fieldkit/weather/hardware/module-board/fk-weather.kicad_pcb

## KiCad design hardware/module-board/fk-weather.kicad_pcb (2018-12-20)

Schematic: fk-weather.sch, fk-core

Parts:
BT1: BATTERY_CELL; BAT_CR1210
C1, C2: 18pF; CAP-0603
C3, C4, C6, C7, C8, C13, C16, C18, C20: 100nF; CAP-0603
C5, C11, C12: 1uF; CAP-0603
C9, C14: 4.7uF; CAP-0603
C10: 4.7nF; CAP-0603
C15, C21: 10uF; CAP-0603
C17, C19: 10nF; CAP-0603
D1: Green; LED-0603
D4: PRTR5V0U2X; SOT-143B
D5: Orange; LED-0603
D6, D7, D8, D9, D10, D11: DIODE; SOD-123
F1: MF-PSMF050X-2; MF-PSMF020X
J1: MICRO-USB; USB_1051330011
J2, J7: CONN_01x05; Molex_CLIK-Mate_502382-0570_1x05_P1.25mm_Vertical
J3: CONN_01x03_SERIAL; Molex_CLIK-Mate_502382-0370_1x03_P1.25mm_Vertical
J4: CONN_01x04; Molex_CLIK-Mate_502382-0470_1x04_P1.25mm_Vertical
J5: MICRO-USB; USB_10118193-0001LF-core-mod
J6: CONN_02x05_SWD; HDR_02x05_Pitch1.27mm_SMD_SWD
J8: CONN_01x04; BM04B-SRSS-TB
J9, J12: CONN_01x02; SJ_OPEN
J10, J11: CONN_01x06; WURTH_615006138421
L1, L2: BLM18KG221SN1D; IND-0603
M1, M2, M3, M4: MOUNT_HOLE; HOLE_NPTH_2.7MM
Q4: 2N7002LT1G; SOT-23
R1, R22, R23, R30, R31, R32, R33: 1K; RES-0603
R2, R9: 330R; RES-0603
R3, R17: 2k2; RES-0603
R4, R5, R12: 10K; RES-0603
R6, R7, R16, R18, R19, R20, R34: 4.7K; RES-0603
R8, R14, R15: 100K; RES-0603
R10: 1M; RES-0603
R11, R13: ?; RES-0603
SW1: SPNO; SW_SPST_WURTH_1
U1: ATSAMD21G18A-AU; TQFP-48_7x7mm_Pitch0.5mm
U2: MCP1700T-3302E/MB; SOT-89
U3: TPS2052B; SOIC-8-N
U4: S25FL116K0XMFI041; SOIC-8-N-WIDE
U5: SK6812
U6: PCF8523; SOIC-8-N
Y1, Y2: FC-135; ABS07

Connections:
3V3: C3.1, C7.1, C8.1, C12.1, C16.1, C17.1, D1.2 (A), D5.2 (A), J2.1, J4.1, J6.1, J7.1, J8.2, J9.1, J12.1, L2.2, R1.1, R4.1, R5.2, R6.2, R7.2, R8.1, R12.2, R16.2, R18.2, R19.2, R20.2, U1.17 (VDDIO), U1.36 (VDDIO), U1.44 (VDDIN), U2.3 (VOUT), U3.2, U5.3 (VDD), U6.8 (VDD)
5V0: C9.1, C11.1, L1.1, U2.2 (VIN)
/A0: U1.3 (PA02)
/A1_WIND_DIR: D8.1 (K), D9.2 (A), R30.2, R34.2, U1.7 (PB08)
/A3: U1.9 (PA04), U5.2 (DI)
/A4: U1.10 (PA05)
/A5: U1.47 (PB02)
/ATN: U1.22 (PA13)
/D0: U1.16 (PA11)
/D1: U1.15 (PA10)
/D2: U1.23 (PA14)
/D5_FLASH_CS: U1.24 (PA15), U4.1 (~CS~)
/D6_RAIN: D6.2 (A), D7.1 (K), R32.2, U1.29 (PA20)
/D7_WEATHER_EN: R11.1, U1.30 (PA21), U3.3
/D8_PERIPH_EN: R13.1, U1.11 (PA06), U3.4
/D9: U1.12 (PA07)
/D10_WIND_SPEED: D10.2 (A), D11.1 (K), R33.2, U1.27 (PA18)
/D12: U1.28 (PA19)
/D13: Q4.1 (G), U1.26 (PA17)
/D30: J3.3 (D30), U1.37 (PB22)
/D31: J3.2 (D31), U1.38 (PB23)
/MISO: U1.21 (PA12), U4.2 (SO/IO1)
/MOSI: U1.19 (PB10), U4.5 (SI/IO0)
/PERIPH_3V3: C18.1, C20.1, C21.1, J9.2, R14.1, U3.6, U4.3 (~WP~/IO2), U4.7 (~HOLD~/IO3), U4.8 (VCC)
/RAIN_2: J10.2
/RAIN_5: J10.5
/RESET: R2.1, U1.40 (RESETN)
/RST: J6.10, R2.2, R4.2, SW1.2; also elsewhere on the board
/RX_LED: U1.48 (PB03)
/SCK: U1.20 (PB11), U4.6 (SCLK)
/SCL1: J4.3, J8.4, R7.1, R20.1, U1.32 (PA23), U6.6 (SCL)
/SCL2: J2.4, J7.4, R18.1, U1.14 (PA09)
/SDA1: J4.4, J8.3, R6.1, R19.1, U1.31 (PA22), U6.5 (SDA)
/SDA2: J2.5, J7.5, R16.1, U1.13 (PA08)
/SWCLK: J6.4, U1.45 (PA30)
/SWDIO: J6.2, U1.46 (PA31)
/TX_LED: U1.39 (PA27)
/USB+: D4.2, J1.3 (D+), J5.3 (D+), U1.34 (PA25)
/USB-: D4.3, J1.2 (D-), J5.2 (D-), U1.33 (PA24)
/USB_ID: R9.2, U1.41 (PA28)
/WEATHER_3V3: C13.1, C15.1, D6.1 (K), D9.1 (K), D10.1 (K), J12.2, R15.1, R34.1, U3.7
GND: BT1.2 (-), C1.1, C2.1, C3.2, C4.2, C5.2, C6.2, C7.2, C8.2, C9.2, C10.2, C11.2, C12.2, C13.2, C14.2, C15.2, C16.2, C17.2, C18.2, C19.2, C20.2, C21.2, D4.1, D7.2 (A), D8.2 (A), D11.2 (A), J1.5 (GND), J2.2, J3.1 (GND), J4.2, J5.5 (GND), J6.3, J6.5, J6.9, J7.2, J8.1, Q4.2 (S), R3.2, R10.2, R11.2, R13.2, R14.2, R15.2, R22.2, R23.2, R31.2, SW1.1, U1.5 (GNDANA), U1.18 (GND), U1.35 (GND), U1.42 (GND), U2.1 (GND), U3.1, U4.4 (VSS), U5.1 (GND), U6.4 (VSS); also elsewhere on the board
unnamed: BT1.1 (+), U6.3 (VBAT)
unnamed: C1.2, U1.2 (PA01), Y1.1
unnamed: C2.2, U1.1 (PA00), Y1.2
unnamed: C4.1, L2.1, U1.6 (VDDANA)
unnamed: C5.1, U1.43 (VDDCORE)
unnamed: C10.1, J1.6 (SHIELD), J5.7 (SHIELD), R10.1
unnamed: C6.1, C14.1, U1.4 (PA03)
unnamed: C19.1, R1.2
unnamed: D1.1 (K), R3.1
unnamed: D5.1 (K), R17.1
unnamed: F1.1, L1.2
unnamed: J1.4 (ID), J5.4 (ID), R8.2, R9.1
unnamed: J10.3, R23.1
unnamed: J10.4, R32.1
unnamed: J11.2, R22.1
unnamed: J11.3, R31.1
unnamed: J11.4, R33.1
unnamed: J11.5, R30.1
unnamed: Q4.3 (D), R17.2
unnamed: R5.1, U3.8
unnamed: R12.1, U3.5
unnamed: U6.1 (XI), Y2.2
unnamed: U6.2 (XO), Y2.1
VUSB: D4.4, F1.2, J1.1 (VBUS), J5.1 (VBUS)

Notes on the sheet:
TX0
RX0
32.768kHz
12.5pF
USB / POWER MANAGEMENT
LEDs
MCU
I2C
EXTERNAL SENSOR
RAIN
WIND
RTC
MOUNTING
FLASH
CORE CONNECTOR
EXTERNAL SERIAL
PERIPHERALS

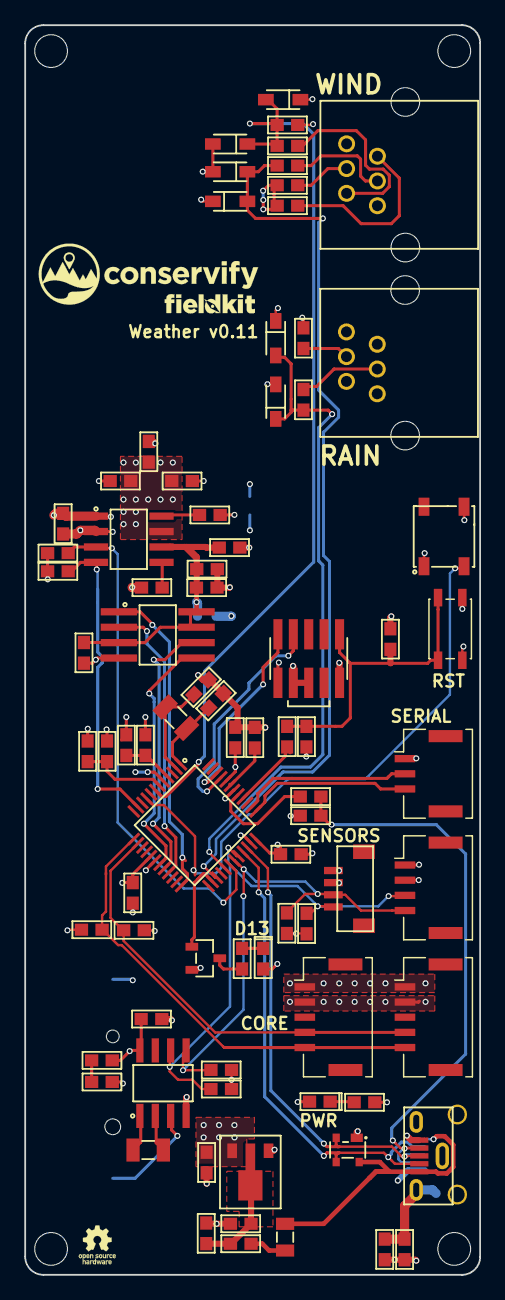
[picture p1: board fk-weather.kicad_pcb from above]

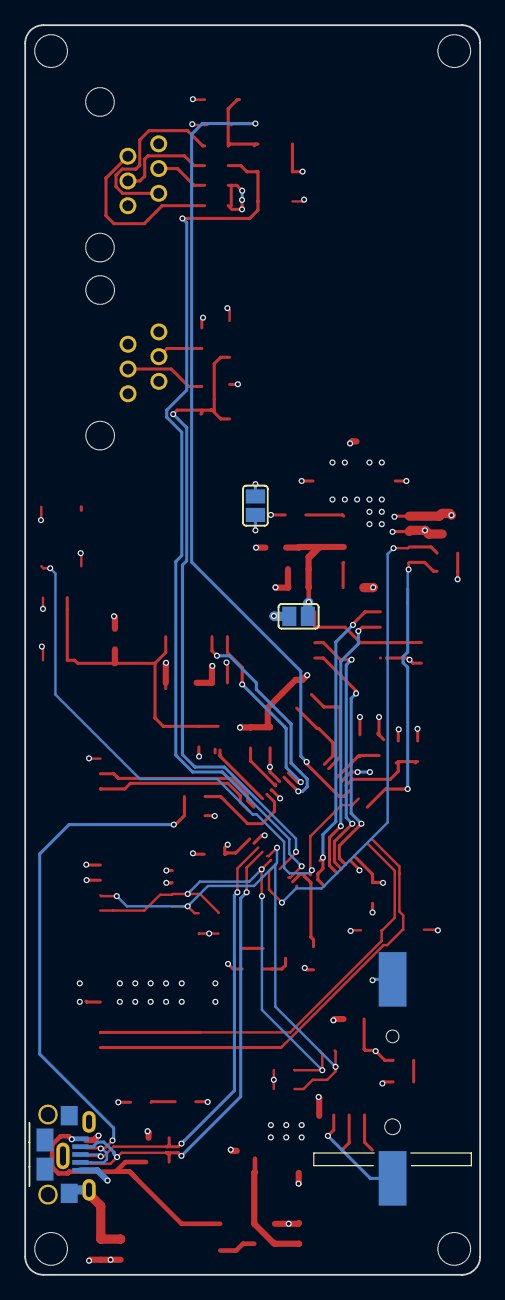
[picture p2: board fk-weather.kicad_pcb from below]

Board: 4 copper layers, 37.5 x 103.0 mm, 88 parts (4 on the bottom side), 53 nets.

Other parts of the board:
C22: 100nF; CAP-0603

Their connections:
/RST: C22.1; also elsewhere on the board
GND: C22.2; also elsewhere on the board
