fieldkit/weather/hardware/sensor-board/fk-weather-sensors.kicad_pcb

## KiCad design hardware/sensor-board/fk-weather-sensors.kicad_pcb (2018-09-24)

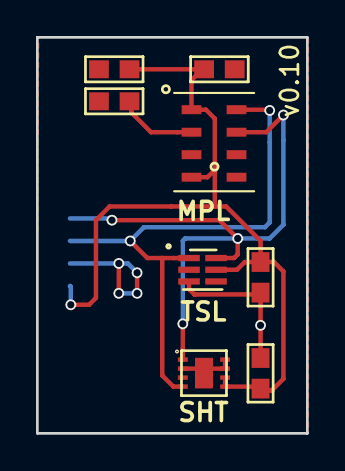
[picture p3: board fk-weather-sensors.kicad_pcb from above]

Board: 2 copper layers, 15.0 x 22.0 mm, 9 parts (1 on the bottom side), 5 nets.

Parts:
C1, C2, C5: 100nF; CAP-0603
C3: 1uF; CAP-0603
C4: 10uF; CAP-0603
J1: CONN_01x04; Molex_CLIK-Mate_502382-0470_1x04_P1.25mm_Vertical
U1: MPL3115A2; DFN-8-1EP_5x2.55mm_Pitch1.25mm_98ASA002260D
U2: TSL2591
U3: SHT31; SHT3x

Connections:
3V3: C2.1, C3.1, C4.1, C5.1, J1.1, U1.1, U1.4, U2.5, U3.5, U3.6
/SCL: J1.3, U1.8, U2.1, U3.4
/SDA: J1.4, U1.7, U2.6, U3.1
GND: C1.2, C2.2, C3.2, C4.2, C5.2, J1.2, U1.3, U2.3, U3.2, U3.7, U3.8, U3.PAD
unnamed: C1.1, U1.2
