fieldkit/weather/firmware/common/ambient_sensors.h

#ifndef FK_AMBIENT_SENSORS_H_INCLUDED
#define FK_AMBIENT_SENSORS_H_INCLUDED

#include "debug.h"
#include "module_hardware.h"

namespace fk {

class AmbientSensors {
private:
    WeatherHardware *hw;

public:
    AmbientSensors(WeatherHardware &hw);

public:
    void takeReading();

};

}

#endif
