fieldkit/weather/firmware/test/check.h

#ifndef FK_CHECK_H_INCLUDED
#define FK_CHECK_H_INCLUDED

#include <module_hardware.h>

namespace fk {

class Check {
private:
    WeatherHardware *hw;

public:
    Check(WeatherHardware &hw);

public:
    bool sht31();
    bool mpl3115a2();
    bool tsl2591();
    bool flashMemory();
    bool check();
    void failed();

};

}

#endif
