fieldkit/weather/(commit log)

2017-03-13 First commit.
    [fk-weather.kicad_pcb, fk-weather.sch]
2017-04-01 Read outside temperature from an attached DHT22
2017-07-25 Starting on the basic sensor module board. Just IC stuff.
    [fk-weather.kicad_pcb, fk-weather.sch]
2017-07-26 Adding pull ups, fixing the outline. Plotting.
    [fk-weather-B.Cu.gbr, fk-weather-B.Mask.gbr, fk-weather-B.Paste.gbr, fk-weather-B.SilkS.gbr, fk-weather-Edge.Cuts.gbr, fk-weather-F.Cu.gbr, fk-weather-F.Mask.gbr, fk-weather-F.Paste.gbr]
2017-07-26 Adding USB connector and 3v3 regulator.
    [fk-weather-B.Cu.gbr, fk-weather-B.Mask.gbr, fk-weather-B.Paste.gbr, fk-weather-B.SilkS.gbr, fk-weather-Edge.Cuts.gbr, fk-weather-F.Cu.gbr, fk-weather-F.Mask.gbr, fk-weather-F.Paste.gbr]
2017-07-26 Adding MAX4466.
    [fk-weather-B.Cu.gbr, fk-weather-B.Mask.gbr, fk-weather-B.Paste.gbr, fk-weather-B.SilkS.gbr, fk-weather-Edge.Cuts.gbr, fk-weather-F.Cu.gbr, fk-weather-F.Mask.gbr, fk-weather-F.Paste.gbr]
2017-07-26 Fix part for ferrite beads, replot.
    [fk-weather-B.Cu.gbr, fk-weather-B.Mask.gbr, fk-weather-B.Paste.gbr, fk-weather-B.SilkS.gbr, fk-weather-Edge.Cuts.gbr, fk-weather-F.Cu.gbr, fk-weather-F.Mask.gbr, fk-weather-F.Paste.gbr]
2017-08-18 Fixing footprints for light and pressure.
    [fk-weather.kicad_pcb, fk-weather.sch]
2017-08-23 Fixing USB oval drills.
    [fk-weather.kicad_pcb, fk-weather.sch]
2017-08-23 Arranging labels for printing out an assembly map.
    [fk-weather.kicad_pcb, fk-weather.sch]
2017-08-24 Working on layout issues, trying to figure out the MCU problem.
    Also broke up power from USB.
    [fk-weather-B.Cu.gbr, fk-weather-B.Mask.gbr, fk-weather-B.Paste.gbr, fk-weather-B.SilkS.gbr, fk-weather-Edge.Cuts.gbr, fk-weather-F.Cu.gbr, fk-weather-F.Mask.gbr, fk-weather-F.Paste.gbr]
2017-09-12 Export new gerbers.
    [fk-weather-B.Cu.gbr, fk-weather-B.Mask.gbr, fk-weather-B.Paste.gbr, fk-weather-B.SilkS.gbr, fk-weather-Edge.Cuts.gbr, fk-weather-F.Cu.gbr, fk-weather-F.Mask.gbr, fk-weather-F.Paste.gbr]
2017-09-14 Programming header was wrong from the SMD switch.
    [fk-weather.kicad_pcb, fk-weather.sch]
2017-09-15 Adding an LED to D13
    [fk-weather.kicad_pcb, fk-weather.sch]
2017-09-15 Removing extraneous headers.
    [fk-weather.kicad_pcb, fk-weather.sch]
2017-09-15 Adding a header for an LED.
    [fk-weather.kicad_pcb, fk-weather.sch]
2017-09-15 Nudge button over.
    [fk-weather.kicad_pcb]
2017-09-27 Wire ADDR on SHT31 to GND.
    [fk-weather.kicad_pcb, fk-weather.sch]
2017-10-02 Some parts.
    [fk-weather.sch]
2017-11-02 Add way to isolate sensors in from the bus in testing.
    [fk-weather.kicad_pcb, fk-weather.sch]
2017-11-02 Separate I2C for BNO055, also break a third out for fk-core.
    [fk-weather.kicad_pcb, fk-weather.sch]
2017-11-03 New gerbers.
    [fk-weather-B.Cu.gbr, fk-weather-B.Mask.gbr, fk-weather-B.Paste.gbr, fk-weather-B.SilkS.gbr, fk-weather-Edge.Cuts.gbr, fk-weather-F.Cu.gbr, fk-weather-F.Mask.gbr, fk-weather-F.Paste.gbr]
2017-11-17 Using a better SHT3x footprint.
    [fk-weather.kicad_pcb, fk-weather.sch]
2017-11-17 Test firmware that runs through all the devices.
2017-11-17 Fixing up some parts to work with our BOM scripts.
    [fk-weather.sch]
2017-11-27 Adding flash memory to the schematic.
    [fk-weather.sch]
2017-11-28 Adding flash memory to PCB. Plotting.
    [fk-weather-B.Cu.gbr, fk-weather-B.Mask.gbr, fk-weather-B.Paste.gbr, fk-weather-B.SilkS.gbr, fk-weather-Edge.Cuts.gbr, fk-weather-F.Cu.gbr, fk-weather-F.Mask.gbr, fk-weather-F.Paste.gbr]
2017-11-29 Rounding corners of the PCB.
    [fk-weather-B.Cu.gbr, fk-weather-B.Mask.gbr, fk-weather-B.Paste.gbr, fk-weather-B.SilkS.gbr, fk-weather-Edge.Cuts.gbr, fk-weather-F.Cu.gbr, fk-weather-F.Mask.gbr, fk-weather-F.Paste.gbr]
2017-12-08 Fix version number.
    [fk-weather-B.Cu.gbr, fk-weather-B.Mask.gbr, fk-weather-B.Paste.gbr, fk-weather-B.SilkS.gbr, fk-weather-Edge.Cuts.gbr, fk-weather-F.Cu.gbr, fk-weather-F.Mask.gbr, fk-weather-F.Paste.gbr]
2017-12-20 Adding another breakout for the MIC to attach a header to for probing.
    [fk-weather.kicad_pcb, fk-weather.sch]
2017-12-20 Make fab labels easier to read.
    [fk-weather.kicad_pcb]
2017-12-21 Reading sensor data. Also some basic analog sampling code.
2017-12-22 Actually fill in module sensor readings.
2017-12-22 Use new module status return for backoff.
    This tells core to give us some time to ourselves so we can use the I2C
    bus to talk to *our* sensors.
2017-12-24 Setup watchdog (to setup the leds)
2017-12-28 Hardware will becoem two boards. Make dir.
    [fk-weather.kicad_pcb, fk-weather.sch]
2017-12-28 Will regenerate these.
    [fk-weather-B.Cu.gbr, fk-weather-B.Mask.gbr, fk-weather-B.Paste.gbr, fk-weather-B.SilkS.gbr, fk-weather-Edge.Cuts.gbr, fk-weather-F.Cu.gbr, fk-weather-F.Mask.gbr, fk-weather-F.Paste.gbr]
2017-12-28 Adding PCB/sch for the wind/rain connectors.
    [fk-weather.kicad_pcb, fk-weather.sch]
2017-12-28 First pass on the sensor board.
    [fk-weather-sensors.kicad_pcb, fk-weather-sensors.sch]
2017-12-28 Removing sensors from module board.
    [fk-weather.kicad_pcb, fk-weather.sch]
2017-12-28 Wire up the I2C buses to the header.
    [fk-weather.kicad_pcb, fk-weather.sch]
2017-12-28 Fix RJ11 jacks. Clean up the board and I2C lines.
    Got rid of the solder jumpers and just broke both out.
    [fk-weather.kicad_pcb, fk-weather.sch]
2017-12-28 Expose Serial2 (D31/D30)
    [fk-weather.kicad_pcb, fk-weather.sch]
2017-12-28 Change header orien. Plot.
    [fk-weather-B.Cu.gbr, fk-weather-B.Mask.gbr, fk-weather-B.Paste.gbr, fk-weather-B.SilkS.gbr, fk-weather-Edge.Cuts.gbr, fk-weather-F.Cu.gbr, fk-weather-F.Mask.gbr, fk-weather-F.Paste.gbr]
2017-12-29 PCB labels for D30/D31
    [fk-weather.kicad_pcb]
2018-01-06 Change version to 0.6.
    [fk-weather-B.Cu.gbr, fk-weather-B.Mask.gbr, fk-weather-B.Paste.gbr, fk-weather-B.SilkS.gbr, fk-weather-Edge.Cuts.gbr, fk-weather-F.Cu.gbr, fk-weather-F.Mask.gbr, fk-weather-F.Paste.gbr]
2018-01-20 Using the prettier footprints for some passives.
    [fk-weather.kicad_pcb, fk-weather.sch]
2018-01-22 Fix TSL2591 footprint.
    [fk-weather-sensors.kicad_pcb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]
2018-01-23 Bugfix, using the same variable twice.
    [readings.cpp]
2018-01-23 Fix number of sensors.
    [main.cpp]
2018-01-23 Using secondary I2C for core communications.
2018-01-23 Initialize the sensors at startup.
2018-01-24 Save persisted state into SerialFlash.
    This ensures our long term values don't get erased and that they stay
    consistent. Especially due to our stability issues on I2C now.
    [WeatherMeters.cpp, WeatherMeters.h, main.cpp]
2018-01-24 Fix persisted save saving. Also uses a lower level mechanism.
    [WeatherMeters.cpp, WeatherMeters.h]
2018-01-25 FlashStorage alternates between two blocks.
    This is so that we have a value to fall back on if we happen to be
    interrupted during a write.
2018-02-15 Plotting new gerbers. Bump version.
    [fk-weather-sensors-B.Cu.gbr, fk-weather-sensors-B.Mask.gbr, fk-weather-sensors-B.Paste.gbr, fk-weather-sensors-B.SilkS.gbr, fk-weather-sensors-F.Cu.gbr, fk-weather-sensors-F.Mask.gbr, fk-weather-sensors-F.SilkS.gbr, fk-weather-sensors.drl]
2018-03-02 Drop daily values, add previous hour of rain and hourly wind gust.
    The idea of a day is awkward in the context of the station because we don't
    necessarily know the time zone, etc... So it's easier to build daily
    values after the fact from hourly information.
    Also, having previous hour is good because that's probably a more accurate
    value than using some arbitrary sample in the current hour.
2018-03-02 Change startup order to setup Watchdog earlier.
    I noticed something hang, probably during scanning for weather sensors and
    hopefully with the earlier watchdog startup we can restart and get out.
2018-03-05 Using key names for sensors. Going to pretty up using metadata.
2018-03-21 Bump revision. Nudge some parts.
    [fk-weather.kicad_pcb]
2018-03-21 Use Zero RTC for our "meters clock" instead of managing our own.
    The idea here is that this will meant he weather meter data is nearly
    always synced to the proper time. Even in the rare cases where we're
    confused about the time. Hell, once we get a time the time is usually
    correct from then on.
    [WeatherMeters.cpp, WeatherMeters.h, main.cpp, readings.cpp]
2018-03-23 Don't try and read other sensors that we can't find.
2018-04-19 Use taskQueue for sensor task.
2018-05-01 Migrate to arduino-logging.
2018-05-07 Add NFET for peripherals. In this case just the flash.
    [fk-weather.kicad_pcb, fk-weather.sch]
2018-05-21 Updating BOM details.
    [fk-weather.sch]
2018-07-03 Add dimensions.
    [fk-weather.kicad_pcb]
2018-07-03 Add connectors. Clean up mounting hole locations.
    [fk-weather.kicad_pcb, fk-weather.sch]
2018-07-06 Adding high side switch for peripherals.
    [fk-weather.kicad_pcb, fk-weather.sch]
2018-07-10 Plotting gerbers.
    [fk-weather-B.Cu.gbr, fk-weather-B.Mask.gbr, fk-weather-B.Paste.gbr, fk-weather-B.SilkS.gbr, fk-weather-Edge.Cuts.gbr, fk-weather-F.Cu.gbr, fk-weather-F.Mask.gbr, fk-weather-F.Paste.gbr]
2018-07-18 Easier to read labels.
    [fk-weather-sensors.kicad_pcb, fk-weather.kicad_pcb]
2018-07-18 Enable peripherals on startup. Also kill them on fatal errors.
    [ModuleHardware.cpp, WeatherMeters.cpp, readings.cpp]
2018-07-23 Drop large header. Add debug. Drop LEDs.
    [fk-weather.kicad_pcb, fk-weather.sch]
2018-07-23 Same size as Core board.
    [fk-weather.kicad_pcb]
2018-07-23 Add RTC. Molex connector cleanup. Add RGB LED.Fix diode footprints.
    [fk-weather-sensors.kicad_pcb, fk-weather-sensors.sch, fk-weather.kicad_pcb, fk-weather.sch]
2018-07-23 Add a second core port.
    [fk-weather.kicad_pcb, fk-weather.sch]
2018-07-24 Nudge holes to match Core pattern, which needed a little more room.
    [fk-weather.kicad_pcb]
2018-07-24 Part for load switch was wrong, fixing.
    [fk-weather.kicad_pcb, fk-weather.sch]
2018-07-25 Upgrade to Kicad 5.
    [fk-weather-2018-07-25-09-59-30.sch, fk-weather-sensors-2018-07-25-09-59-47.sch, fk-weather-sensors.kicad_pcb, fk-weather.kicad_pcb]
2018-07-27 New USB for vertical entry.
    [fk-weather-B.Cu.gbr, fk-weather-B.Mask.gbr, fk-weather-B.Paste.gbr, fk-weather-B.SilkS.gbr, fk-weather-Edge.Cuts.gbr, fk-weather-F.Cu.gbr, fk-weather-F.Mask.gbr, fk-weather-F.Paste.gbr]
2018-07-30 Fix a few small traces and the silkscreen.
    [fk-weather-B.Cu.gbr, fk-weather-B.Mask.gbr, fk-weather-B.Paste.gbr, fk-weather-B.SilkS.gbr, fk-weather-Edge.Cuts.gbr, fk-weather-F.Cu.gbr, fk-weather-F.Mask.gbr, fk-weather-F.Paste.gbr]
2018-08-22 Consistent part values across our schematics.
    [fk-weather.sch]
2018-08-22 Part updates.
    [fk-weather-sensors.sch, fk-weather.sch]
2018-08-24 Fix SK6812 and cleanup signal naming.
    [fk-weather.kicad_pcb, fk-weather.sch]
2018-08-24 Fix rescued stuff and clear DRC problems.
    [fk-weather-sensors.kicad_pcb, fk-weather-sensors.sch, fk-weather.kicad_pcb, fk-weather.sch]
2018-08-28 Rename class to avoid collision.
    [AmbientSensors.cpp, AmbientSensors.h, ModuleHardware.cpp, WeatherMeters.cpp, main.cpp, readings.cpp, readings.h]
2018-08-28 Use more compatible FP for flash.
    [fk-weather.kicad_pcb, fk-weather.sch]
2018-08-28 Schematic/FP cleanup. Nothing major.
    [fk-weather.kicad_pcb, fk-weather.sch]
2018-08-28 Consistency in part values
    [fk-weather-sensors.sch, fk-weather.sch]
2018-09-07 Bump version and plot gerbers.
    [fk-weather-B.Cu.gbr, fk-weather-B.Mask.gbr, fk-weather-B.Paste.gbr, fk-weather-B.SilkS.gbr, fk-weather-Edge.Cuts.gbr, fk-weather-F.Cu.gbr, fk-weather-F.Mask.gbr, fk-weather-F.Paste.gbr]
2018-09-20 Fix labels.
    [fk-weather.kicad_pcb]
2018-09-24 Labels on sensor board.
    [fk-weather-sensors.kicad_pcb]
2018-09-24 Better markings for easier placing on sensors.
    [fk-weather-sensors.kicad_pcb]
2018-09-26 Pin to newer library versions.
2018-09-27 Quick fix for persistence issue, leave MinimumFlashState alone.
    [WeatherMeters.cpp, WeatherMeters.h]
2018-11-07 Adding some pull downs.
    [fk-weather-B.Cu.gbr, fk-weather-B.Mask.gbr, fk-weather-B.Paste.gbr, fk-weather-B.SilkS.gbr, fk-weather-Edge.Cuts.gbr, fk-weather-F.Cu.gbr, fk-weather-F.Mask.gbr, fk-weather-F.Paste.gbr]
2018-11-08 Fixing font sizes on schematic.
    [fk-weather.sch]
2018-11-19 Moving labels around.
    [fk-weather.kicad_pcb]
2018-12-04 Add orientation indicator to SWD fp.
    [fk-weather.kicad_pcb, fk-weather.sch]
2018-12-04 Switch to 2.7mm mounting holes.
    [fk-weather.kicad_pcb, fk-weather.sch]
2018-12-04 Remove extra trace.
    [fk-weather.kicad_pcb]
2018-12-11 Pull boards peripheral enable/disable into one location.
2018-12-12 Use new board definition style.
2018-12-20 Started replacing parts on the weather board, including the USB connectors and the switching component
    [fk-weather.kicad_pcb, fk-weather.sch]
2018-12-20 Swapped to 4 layer
    [fk-weather.kicad_pcb, fk-weather.sch]
2018-12-20 Finished v0.11, generated gerbers
    [fk-weather-B.Cu.gbr, fk-weather-B.Mask.gbr, fk-weather-B.Paste.gbr, fk-weather-B.SilkS.gbr, fk-weather-Edge.Cuts.gbr, fk-weather-F.Cu.gbr, fk-weather-F.Mask.gbr, fk-weather-F.Paste.gbr]
2018-12-20 Added debounce capacitor and regenerated v0.11 gerbers
    [fk-weather-B.Cu.gbr, fk-weather-B.Mask.gbr, fk-weather-B.Paste.gbr, fk-weather-B.SilkS.gbr, fk-weather-Edge.Cuts.gbr, fk-weather-F.Cu.gbr, fk-weather-F.Mask.gbr, fk-weather-F.Paste.gbr]
2018-12-20 Schematic cleanup
    [fk-weather.sch]
2019-01-02 Added 02x03 panelized version of the PCB for manufacture, including gerber files
    [fk-weather-v0.11-02x03-B.Cu.gbr, fk-weather-v0.11-02x03-B.Mask.gbr, fk-weather-v0.11-02x03-B.Paste.gbr, fk-weather-v0.11-02x03-B.SilkS.gbr, fk-weather-v0.11-02x03-Edge.Cuts.gbr, fk-weather-v0.11-02x03-F.Cu.gbr, fk-weather-v0.11-02x03-F.Mask.gbr, fk-weather-v0.11-02x03-F.Paste.gbr]
2019-01-29 Regenerated gerbers.
    [fk-weather-sensors-B.Cu.gbr, fk-weather-sensors-B.Mask.gbr, fk-weather-sensors-B.Paste.gbr, fk-weather-sensors-B.SilkS.gbr, fk-weather-sensors-F.Cu.gbr, fk-weather-sensors-F.Mask.gbr, fk-weather-sensors-F.Paste.gbr, fk-weather-sensors-F.SilkS.gbr]
2019-02-12 Use board wrapper to initialize.
2019-02-15 If check fails just gather wind meter data.
    [main.cpp]
2019-03-13 Fixed missing resistor values.
    [fk-weather.sch]
